Breschdling/Brauknecht/HW/PCBoutline.dxf

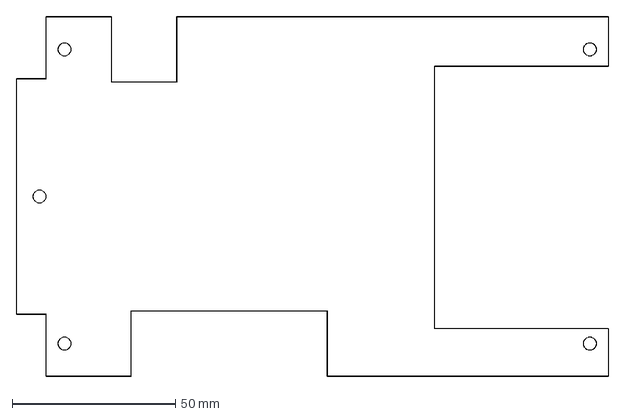
[picture p1: CAD file, 2023-01-19]
HW/PCBoutline.dxf
181.2 x 110.2 mm
