Breschdling/Brauknecht/(list of files, cad)

Other CAD files:
HW/G2111.skp
HW/PCBoutline.skp
