Breschdling/Brauknecht/HW/Wuerzepumpe.pdf

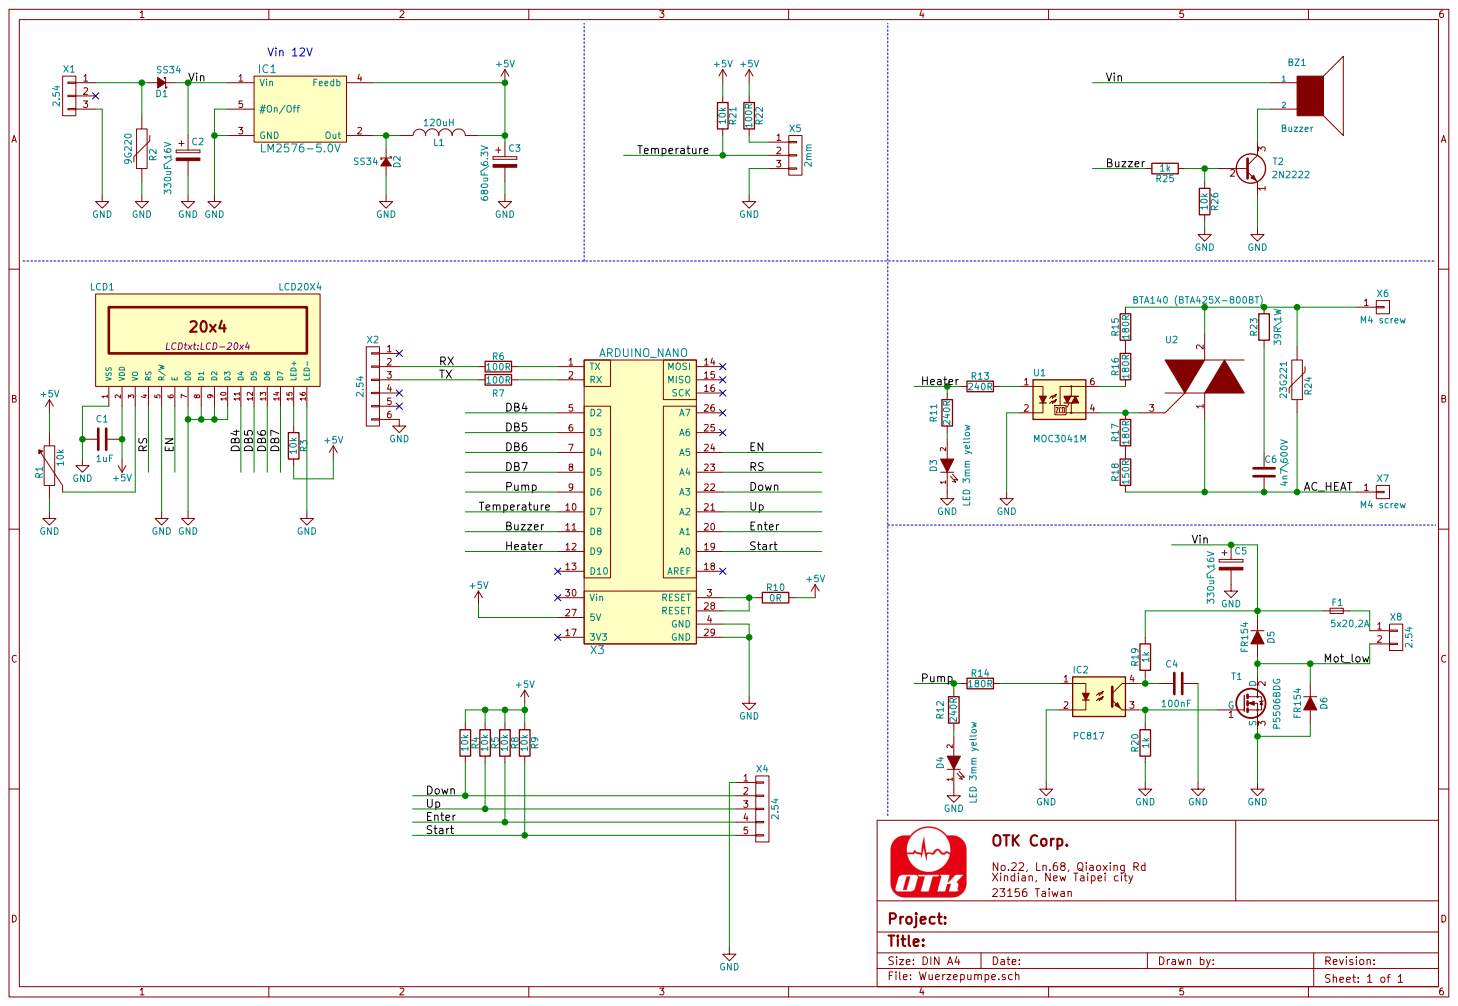
[picture p2: page 1]

1 2 D4 LED 3mm yellow R12 240R GND GND RX

5 X4 2.54 GND Down UpEnter Start

No.22, Ln.68, Qiaoxing Rd
