Breschdling/Brauknecht/HW/g2111_g3113_b.pdf

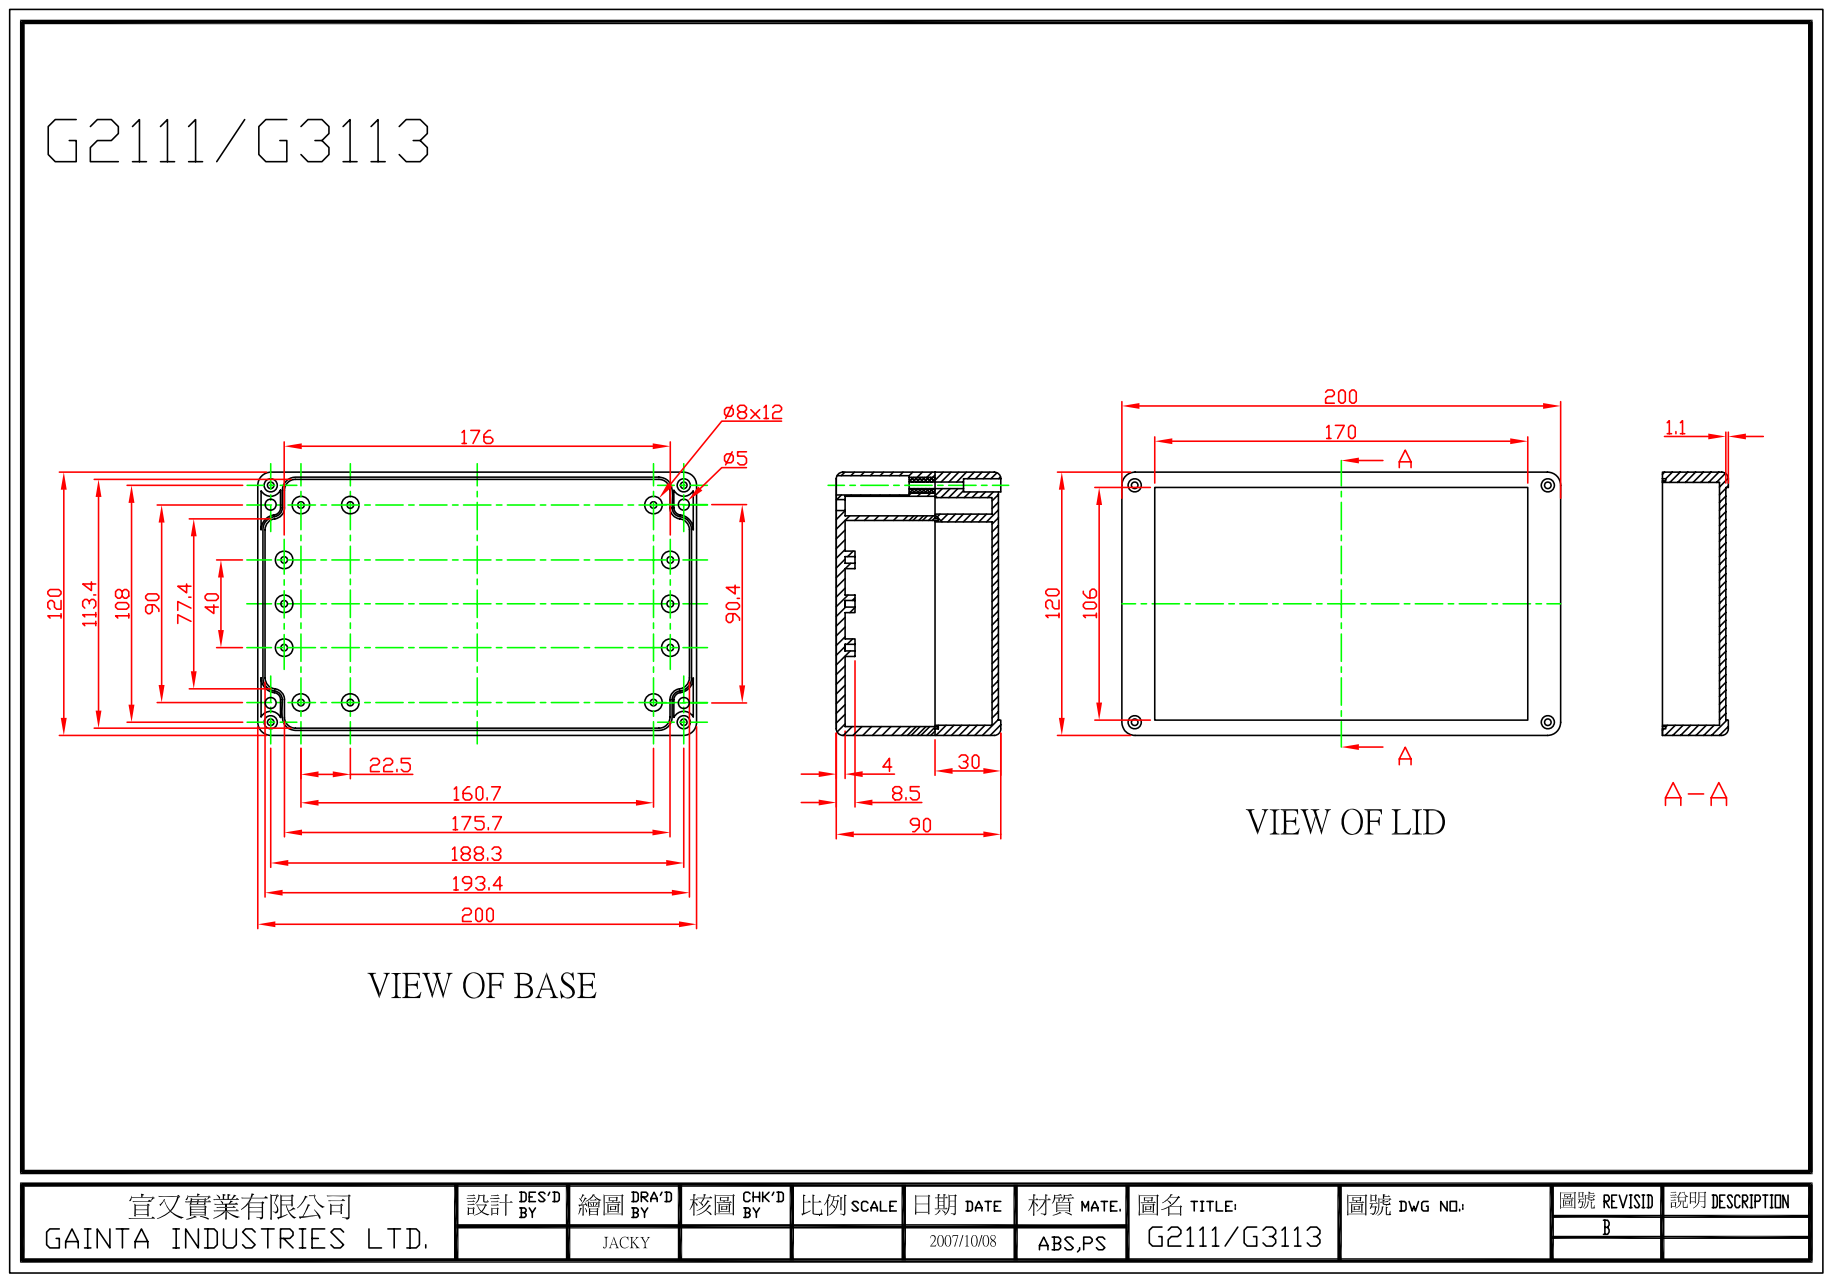
[picture p3: page 1]
