Breschdling/Brauknecht/HW/Wuerzepumpe.kicad_pcb

## KiCad design HW/Wuerzepumpe.kicad_pcb (2023-01-19)

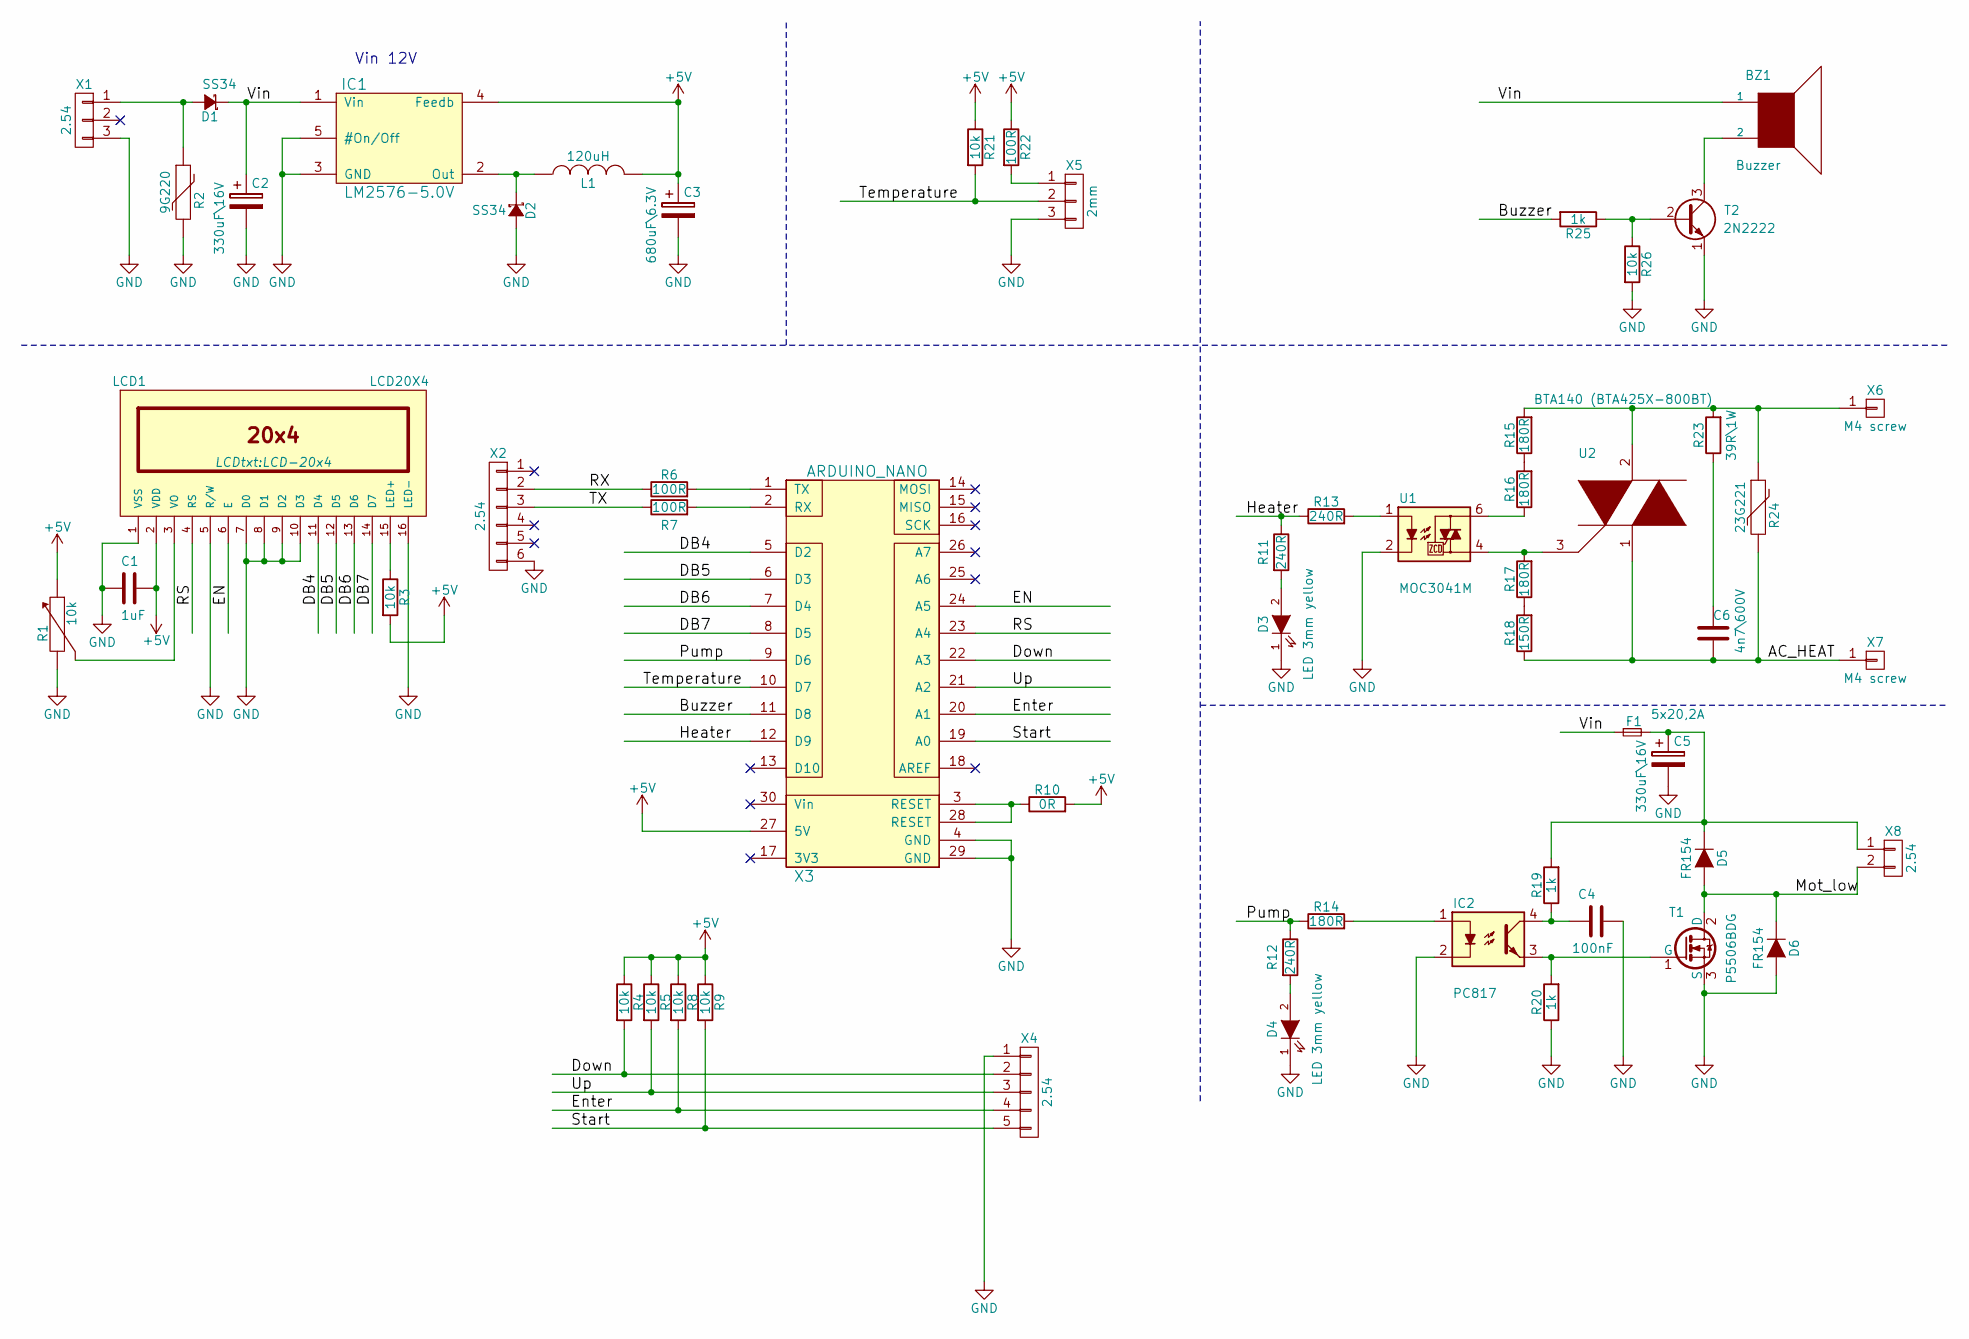
[picture p4: schematic Wuerzepumpe.sch]

Parts:
BZ1: Buzzer; Buzzer_13.8x7.5RM7.6
C1: 1uF; C_0805_HandSoldering
C2, C5: 330uF\\16V; CP_Radial_D10.0mm_P5.00mm_P7.50mm
C3: 680uF\\6.3V; CP_Radial_D10.0mm_P5.00mm_P7.50mm
C4: 100nF; C_0805_HandSoldering
C6: 4n7\\600V; C_Disc_D8.0mm_W5.0mm_P7.50mm
D1, D2: SS34; D_SMA_Handsoldering
D3, D4: LED 3mm yellow; LED_D3.0mm
D5, D6: FR154; D_DO-15_P2.54mm_Vertical_AnodeUp
F1: 5x20,2A; Fuseholder5x20_horiz_open_Schurter_0031_8201
IC1: LM2576-5.0V; TO-263-5Lead
IC2: PC817; DIP-4_W7.62mm_LongPads
L1: 120uH; 16mm_Radial
LCD1: LCD20X4; LCD-20x4
R1: 10k; GF063P1-3
R2: 9G220; RV_Disc_D9_W3.4_P5
R3, R4, R5, R8, R9, R21, R26: 10k; R_0805_HandSoldering
R6, R7, R22: 100R; R_0805_HandSoldering
R10: 0R; R_0805_HandSoldering
R11, R12, R13: 240R; R_0805_HandSoldering
R14, R15, R16, R17: 180R; R_0805_HandSoldering
R18: 150R; R_0805_HandSoldering
R19, R20, R25: 1k; R_0805_HandSoldering
R23: 39R\\1W; R_Axial_DIN0204_L3.6mm_D1.6mm_P2.54mm_Vertical
R24: 23G221; RV_Disc_D15.5_W3.9_P7.5
T1: P5506BDG; TO-252-2Lead
T2: 2N2222; TO-92_Inline_Narrow_Oval
U1: MOC3041M; DIP-6_W7.62mm
U2: BTA140 (BTA425X-800BT); TO-220_Neutral123_Vertical_LargePads
X1: 2.54; Molex_KK-6410-03_03x2.54mm_Straight
X2: 2.54; Pin_Header_Straight_1x06_Pitch2.54mm
X3: ARDUINO_NANO; arduino_nano
X4: 2.54; Pin_Header_Straight_1x05_Pitch2.54mm
X5: 2mm; Molex_MicroLatch-53253-0370_03x2.00mm_Straight
X6, X7: M4 screw; GD-G13
X8: 2.54; Molex_KK-6410-02_02x2.54mm_Straight

Connections:
+5V: C1.1, C3.1, IC1.4 (Feedb), L1.2, LCD1.2 (VDD), R1.1, R3.2, R4.1, R5.1, R8.1, R9.1, R10.2, R21.1, R22.1, X3.27 (5V)
/AC_HEAT: C6.1, R18.1, R24.2, U2.1, X7.1
/Buzzer: R25.2, X3.11 (D8)
/DB4: LCD1.11 (D4), X3.5 (D2)
/DB5: LCD1.12 (D5), X3.6 (D3)
/DB6: LCD1.13 (D6), X3.7 (D4)
/DB7: LCD1.14 (D7), X3.8 (D5)
/Down: R4.2, X3.22 (A3), X4.2
/EN: LCD1.6 (E), X3.24 (A5)
/Enter: R8.2, X3.20 (A1), X4.4
/Heater: R11.1, R13.1, X3.12 (D9)
/Mot_low: D5.2 (A), D6.1 (K), T1.2 (D), X8.2
/Pump: R12.1, R14.1, X3.9 (D6)
/RS: LCD1.4 (RS), X3.23 (A4)
/RX: R6.1, X2.2
/Start: R9.2, X3.19 (A0), X4.5
/TX: R7.1, X2.3
/Temperature: R21.2, X3.10 (D7), X5.2
/Up: R5.2, X3.21 (A2), X4.3
/Vin: BZ1.1, C2.1, D1.1 (K), F1.1, IC1.1 (Vin)
GND: C1.2, C2.2, C3.2, C4.2, C5.2, D2.2 (A), D3.1 (K), D4.1 (K), D6.2 (A), IC1.3 (GND), IC1.5 (#On/Off), IC2.2, LCD1.1 (VSS), LCD1.5 (R/W), LCD1.7 (D0), LCD1.8 (D1), LCD1.9 (D2), LCD1.10 (D3), LCD1.16 (LED-), R1.3, R2.2, R20.1, R26.2, T1.3 (S), T2.1 (E), U1.2, X1.3, X2.6, X3.4 (GND), X3.29 (GND), X4.1, X5.3
unnamed: BZ1.2, T2.3 (C)
unnamed: C4.1, IC2.4, R19.1
unnamed: C5.1, D5.1 (K), F1.2, R19.2, X8.1
unnamed: C6.2, R23.1
unnamed: D1.2 (A), R2.1, X1.1
unnamed: D2.1 (K), IC1.2 (Out), L1.1
unnamed: D3.2 (A), R11.2
unnamed: D4.2 (A), R12.2
unnamed: IC2.1, R14.2
unnamed: IC2.3, R20.2, T1.1 (G)
unnamed: LCD1.3 (VO), R1.2
unnamed: LCD1.15 (LED+), R3.1
unnamed: R6.2, X3.1 (TX)
unnamed: R7.2, X3.2 (RX)
unnamed: R10.1, X3.3 (RESET), X3.28 (RESET)
unnamed: R13.2, U1.1
unnamed: R15.1, R16.2
unnamed: R15.2, R23.2, R24.1, U2.2, X6.1
unnamed: R16.1, U1.6
unnamed: R17.1, R18.2
unnamed: R17.2, U1.4, U2.3
unnamed: R22.2, X5.1
unnamed: R25.1, R26.1, T2.2 (B)

Notes on the sheet:
Vin 12V

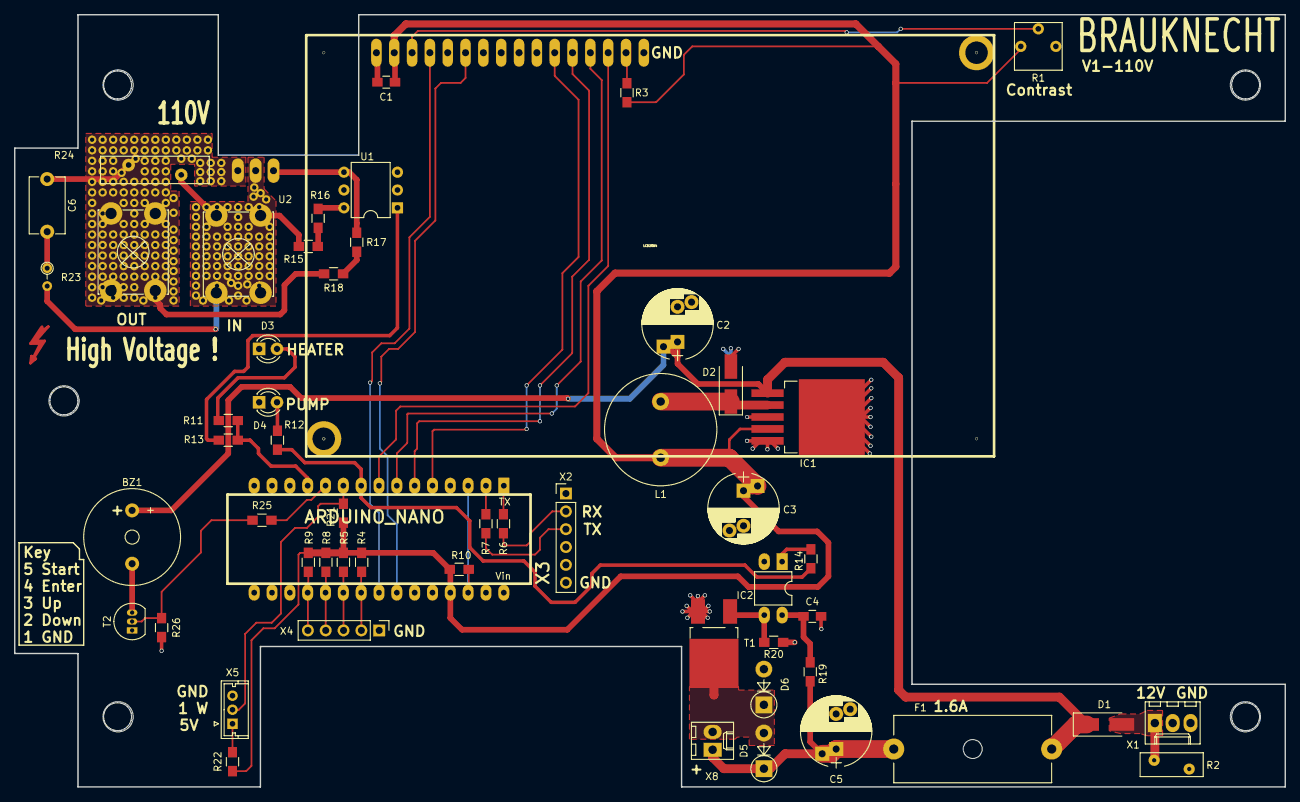
[picture p5: board Wuerzepumpe.kicad_pcb from above]

Board: 2 copper layers, 181.0 x 110.0 mm, 55 parts (1 on the bottom side), 36 nets.
